lincolnxlw/Teensy-4.1-example/Teensy4.1-example.kicad_pcb

## KiCad design Teensy4.1-example.kicad_pcb (2024-11-22)

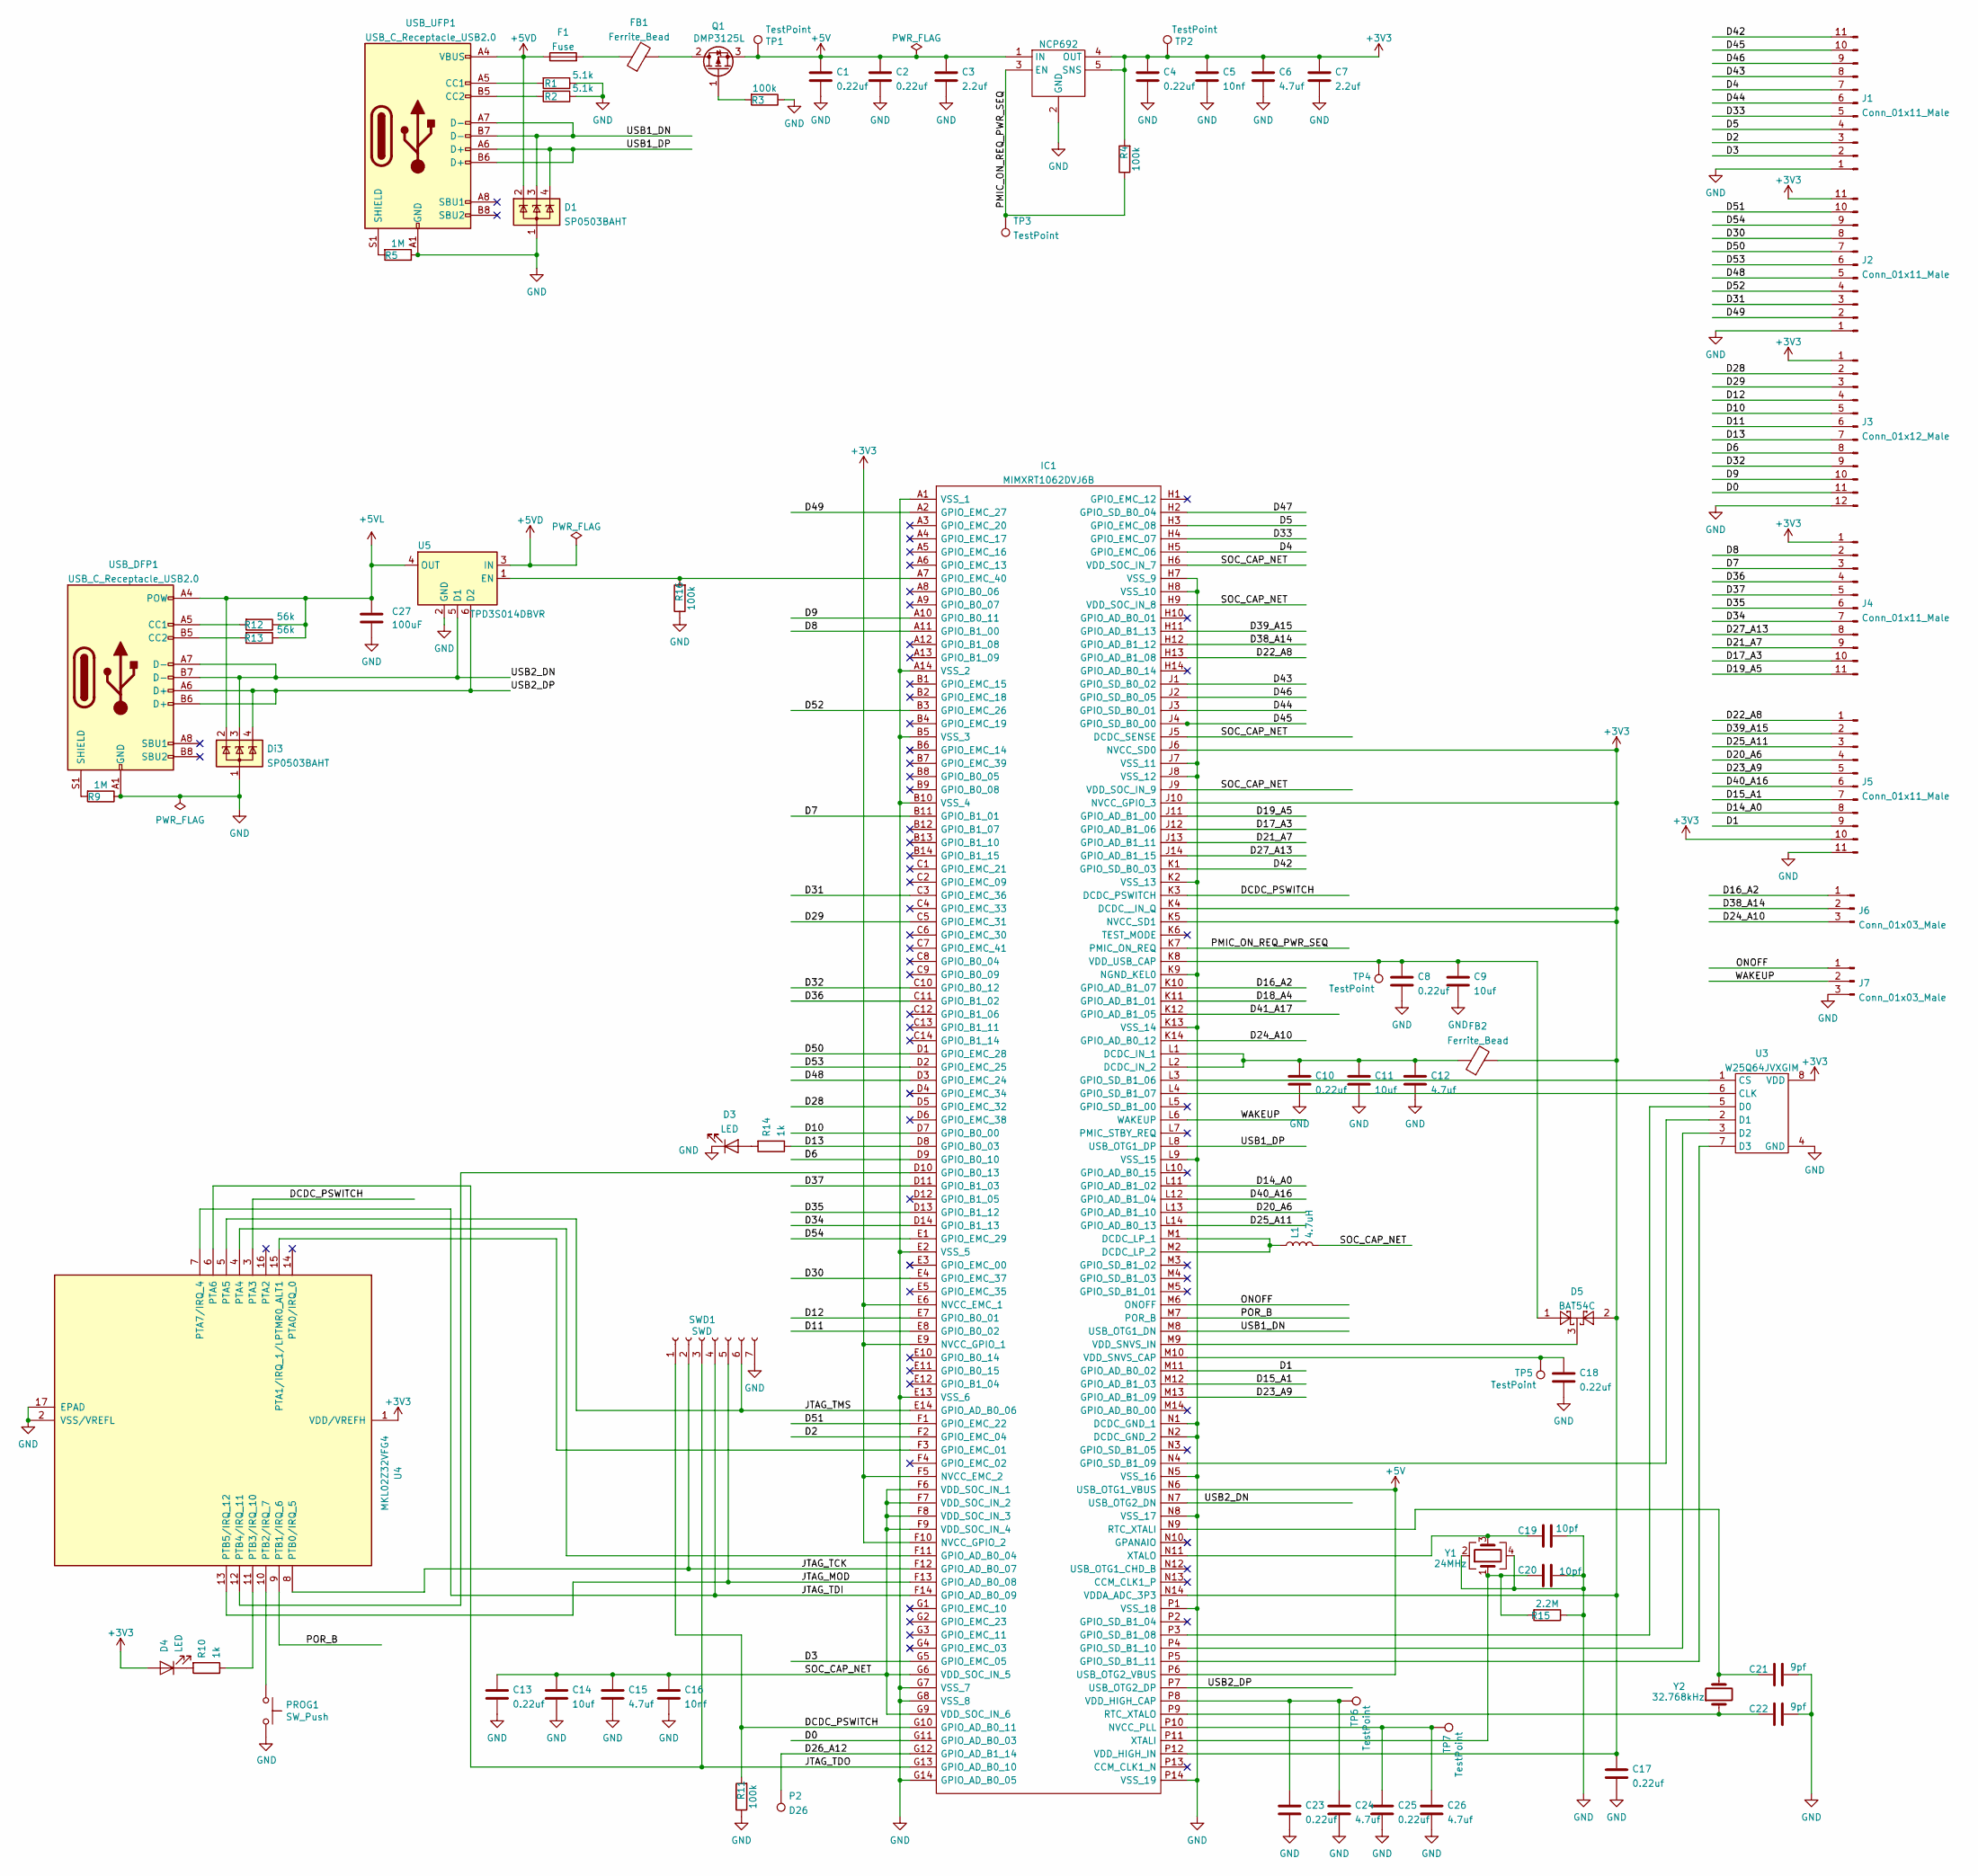
[picture p1: schematic Teensy4.1-example.kicad_sch, Teensy 4.1 example design Kicad]

Parts:
C1, C2, C4, C8, C10, C13, C17, C18, C23, C25: 0.22uf; C_0603_1608Metric; MPN CC0603KRX7R6BB224; LCSC C106216
C3, C7: 2.2uf; C_0603_1608Metric; MPN CL10B225KP8NNNC; LCSC C100082
C5, C16: 10nf; C_0603_1608Metric; MPN 0603B103K160CT; LCSC C163173
C6, C12, C15, C24, C26: 4.7uf; C_0603_1608Metric; MPN CL10B475KQ8NQNC; LCSC C107368
C9, C11, C14: 10uf; C_0805_2012Metric; MPN GRM21BR71A106KA73K; LCSC C2167686
C19, C20: 10pf; C_0603_1608Metric; MPN CC0603KRX7R6BB224; LCSC C1634
C21, C22: 9pf; C_0603_1608Metric; MPN GRM1885C1H9R0DA01D; LCSC C430713
C27: 100uF; C_1206_3216Metric; LCSC C883598
D1: SP0503BAHT; SOT-143; LCSC C3040626
D3, D4: LED; LED_0402_1005Metric; LCSC C264407
D5: BAT54C; SOT-23; LCSC C266596
Di3: SP0503BAHT; SOT-143; LCSC C3040626
F1: Fuse; R_0805_2012Metric; MPN 0ZCK0050FF2E; LCSC C5220829
FB1, FB2: Ferrite_Bead; R_0805_2012Metric; MPN FBMH2012HM121-T‎; LCSC C454098
IC1: MIMXRT1062DVJ6B; BGA196C80P14X14_1200X1200X152; Mouser Part Number 771-MIMXRT1062DVJ6B
J1, J2, J4, J5: Conn_01x11_Male; PinHeader_1x11_P2.54mm_Vertical
J3: Conn_01x12_Male; PinHeader_1x12_P2.54mm_Vertical
J6, J7: Conn_01x03_Male; PinHeader_1x03_P2.54mm_Vertical
L1: 4.7uH; C_0805_2012Metric; MPN LQM21PN4R7MGRD; LCSC C86090
NCP692: OnSemi NCP692, fixed version; DFN-6-1EP_3x3mm_P0.95mm_EP1.7x2.6mm; MPN NCP692MN33T2G; LCSC C145519
P2: D26; PinHeader_1x01_P1.00mm_Vertical
PROG1: SW_Push; KMR241GLFS; MPN KMR241GLFS; LCSC C221682
Q1: DMP3125L; SOT-23; LCSC C459542
R1, R2: 5.1k; R_0603_1608Metric; MPN RC0603FR-075K1L; LCSC C105580
R3, R4, R11, R16: 100k; R_0603_1608Metric; LCSC C15458
R5, R9: 1M; R_0603_1608Metric; LCSC C22935
R10, R14: 1k; R_0402_1005Metric; LCSC C11702
R12, R13: 56k; R_0603_1608Metric; MPN RMCF0603FT56K0; LCSC C23206
R15: 2.2M; R_0603_1608Metric; LCSC C18679
SWD1: SWD; PinHeader_1x07_P1.27mm_Vertical
TP1, TP2, TP3, TP4, TP5, TP6, TP7: TestPoint; TestPoint_Pad_D1.0mm
U3: W25Q64JVXGIM; XSON8_4x4mm; LCSC C5440778
U4: MKL02Z32VFG4; QFN-16-1EP_3x3mm_P0.5mm_EP1.8x1.8mm; MPN Custom firmware part
U5: TPD3S014DBVR; SOT-23-6; LCSC C87384
USB_DFP1: USB_C_Receptacle_USB2.0; TYPE-C-31-M-14; LCSC C223907
USB_UFP1: USB_C_Receptacle_USB2.0; TYPE-C-31-M-14; LCSC C223907
Y1: 24MHz; Crystal_SMD_Abracon_ABM3B-4Pin_5.0x3.2mm; LCSC C5544458
Y2: 32.768kHz; Crystal_SMD_2012-2Pin_2.0x1.2mm; MPN ABS06-32.768KHZ-9-1-T; LCSC C510776

Connections:
+3V3: C4.1, C5.1, C6.1, C7.1, C17.1, D4.2 (A), D5.2, FB2.2, IC1.E6 (NVCC_EMC_1), IC1.E9 (NVCC_GPIO_1), IC1.F5 (NVCC_EMC_2), IC1.F10 (NVCC_GPIO_2), IC1.J6 (NVCC_SD0), IC1.J10 (NVCC_GPIO_3), IC1.K4 (DCDC__IN_Q), IC1.K5 (NVCC_SD1), IC1.N14 (VDDA_ADC_3P3), IC1.P12 (VDD_HIGH_IN), J2.11, J3.1, J4.1, J5.10, NCP692.4 (OUT), NCP692.5 (SNS), R4.2, TP2.1, U3.8 (VDD), U4.1 (VDD/VREFH)
+5V: C1.1, C2.1, C3.1, IC1.N6 (USB_OTG1_VBUS), IC1.P6 (USB_OTG2_VBUS), NCP692.1 (IN), NCP692.6 (IN), Q1.3 (S), TP1.1
+5VD: D1.2 (K), F1.1, U5.3 (IN), USB_UFP1.A4 (VBUS), USB_UFP1.A9 (VBUS), USB_UFP1.B4 (VBUS), USB_UFP1.B9 (VBUS)
+5VL: C27.1, Di3.2 (K), R12.1, R13.1, U5.4 (OUT), USB_DFP1.A4 (POW), USB_DFP1.A9 (POW), USB_DFP1.B4 (POW), USB_DFP1.B9 (POW)
/D0: IC1.G11 (GPIO_AD_B0_03), J3.11
/D1: IC1.M11 (GPIO_AD_B0_02), J5.9
/D2: IC1.F2 (GPIO_EMC_04), J1.3
/D3: IC1.G5 (GPIO_EMC_05), J1.2
/D4: IC1.H5 (GPIO_EMC_06), J1.7
/D5: IC1.H3 (GPIO_EMC_08), J1.4
/D6: IC1.D9 (GPIO_B0_10), J3.8
/D7: IC1.B11 (GPIO_B1_01), J4.3
/D8: IC1.A11 (GPIO_B1_00), J4.2
/D9: IC1.A10 (GPIO_B0_11), J3.10
/D10: IC1.D7 (GPIO_B0_00), J3.5
/D11: IC1.E8 (GPIO_B0_02), J3.6
/D12: IC1.E7 (GPIO_B0_01), J3.4
/D13: IC1.D8 (GPIO_B0_03), J3.7, R14.1
/D14_A0: IC1.L11 (GPIO_AD_B1_02), J5.8
/D15_A1: IC1.M12 (GPIO_AD_B1_03), J5.7
/D16_A2: IC1.K10 (GPIO_AD_B1_07), J6.1
/D17_A3: IC1.J12 (GPIO_AD_B1_06), J4.10
/D18_A4: IC1.K11 (GPIO_AD_B1_01)
/D19_A5: IC1.J11 (GPIO_AD_B1_00), J4.11
/D20_A6: IC1.L13 (GPIO_AD_B1_10), J5.4
/D21_A7: IC1.J13 (GPIO_AD_B1_11), J4.9
/D22_A8: IC1.H13 (GPIO_AD_B1_08), J5.1
/D23_A9: IC1.M13 (GPIO_AD_B1_09), J5.5
/D24_A10: IC1.K14 (GPIO_AD_B0_12), J6.3
/D25_A11: IC1.L14 (GPIO_AD_B0_13), J5.3
/D26_A12: IC1.G12 (GPIO_AD_B1_14), P2.1
/D27_A13: IC1.J14 (GPIO_AD_B1_15), J4.8
/D28: IC1.D5 (GPIO_EMC_32), J3.2
/D29: IC1.C5 (GPIO_EMC_31), J3.3
/D30: IC1.E4 (GPIO_EMC_37), J2.8
/D31: IC1.C3 (GPIO_EMC_36), J2.3
/D32: IC1.C10 (GPIO_B0_12), J3.9
/D33: IC1.H4 (GPIO_EMC_07), J1.5
/D34: IC1.D14 (GPIO_B1_13), J4.7
/D35: IC1.D13 (GPIO_B1_12), J4.6
/D36: IC1.C11 (GPIO_B1_02), J4.4
/D37: IC1.D11 (GPIO_B1_03), J4.5
/D38_A14: IC1.H12 (GPIO_AD_B1_12), J6.2
/D39_A15: IC1.H11 (GPIO_AD_B1_13), J5.2
/D40_A16: IC1.L12 (GPIO_AD_B1_04), J5.6
/D41_A17: IC1.K12 (GPIO_AD_B1_05)
/D42: IC1.K1 (GPIO_SD_B0_03), J1.11
/D43: IC1.J1 (GPIO_SD_B0_02), J1.8
/D44: IC1.J3 (GPIO_SD_B0_01), J1.6
/D45: IC1.J4 (GPIO_SD_B0_00), J1.10
/D46: IC1.J2 (GPIO_SD_B0_05), J1.9
/D47: IC1.H2 (GPIO_SD_B0_04)
/D48: IC1.D3 (GPIO_EMC_24), J2.5
/D49: IC1.A2 (GPIO_EMC_27), J2.2
/D50: IC1.D1 (GPIO_EMC_28), J2.7
/D51: IC1.F1 (GPIO_EMC_22), J2.10
/D52: IC1.B3 (GPIO_EMC_26), J2.4
/D53: IC1.D2 (GPIO_EMC_25), J2.6
/D54: IC1.E1 (GPIO_EMC_29), J2.9
/DCDC_PSWITCH: IC1.G10 (GPIO_AD_B0_11), IC1.K3 (DCDC_PSWITCH), R11.2, SWD1.1, U4.3 (PTA3)
/JTAG_MOD: IC1.F13 (GPIO_AD_B0_08), SWD1.5, U4.13 (PTB5/IRQ_12)
/JTAG_TCK: IC1.F12 (GPIO_AD_B0_07), SWD1.2, U4.8 (PTB0/IRQ_5)
/JTAG_TDI: IC1.F14 (GPIO_AD_B0_09), SWD1.4, U4.7 (PTA7/IRQ_4)
/JTAG_TDO: IC1.G13 (GPIO_AD_B0_10), SWD1.3, U4.6 (PTA6)
/JTAG_TMS: IC1.E14 (GPIO_AD_B0_06), SWD1.6, U4.5 (PTA5)
/ONOFF: IC1.M6 (ONOFF), J7.1
/PMIC_ON_REQ_PWR_SEQ: IC1.K7 (PMIC_ON_REQ), NCP692.3 (EN), R4.1, TP3.1
/POR_B: IC1.M7 (POR_B), U4.9 (PTB1/IRQ_6)
/SOC_CAP_NET: C13.1, C14.1, C15.1, C16.1, IC1.F6 (VDD_SOC_IN_1), IC1.F7 (VDD_SOC_IN_2), IC1.F8 (VDD_SOC_IN_3), IC1.F9 (VDD_SOC_IN_4), IC1.G6 (VDD_SOC_IN_5), IC1.G9 (VDD_SOC_IN_6), IC1.H6 (VDD_SOC_IN_7), IC1.H9 (VDD_SOC_IN_8), IC1.J5 (DCDC_SENSE), IC1.J9 (VDD_SOC_IN_9), L1.2
/USB1_DN: D1.3 (K), IC1.M8 (USB_OTG1_DN), USB_UFP1.A7 (D-), USB_UFP1.B7 (D-)
/USB1_DP: D1.4 (K), IC1.L8 (USB_OTG1_DP), USB_UFP1.A6 (D+), USB_UFP1.B6 (D+)
/USB2_DN: Di3.3 (K), IC1.N7 (USB_OTG2_DN), U5.5 (D1), USB_DFP1.A7 (D-), USB_DFP1.B7 (D-)
/USB2_DP: Di3.4 (K), IC1.P7 (USB_OTG2_DP), U5.6 (D2), USB_DFP1.A6 (D+), USB_DFP1.B6 (D+)
/WAKEUP: IC1.L6 (WAKEUP), J7.2
GND: C1.2, C2.2, C3.2, C4.2, C5.2, C6.2, C7.2, C8.2, C9.2, C10.2, C11.2, C12.2, C13.2, C14.2, C15.2, C16.2, C17.2, C18.2, C19.2, C20.2, C21.2, C22.2, C23.2, C24.2, C25.2, C26.2, C27.2, D1.1 (A), D3.1 (K), Di3.1 (A), IC1.A1 (VSS_1), IC1.A14 (VSS_2), IC1.B5 (VSS_3), IC1.B10 (VSS_4), IC1.E2 (VSS_5), IC1.E13 (VSS_6), IC1.G7 (VSS_7), IC1.G8 (VSS_8), IC1.G14 (GPIO_AD_B0_05), IC1.H7 (VSS_9), IC1.H8 (VSS_10), IC1.J7 (VSS_11), IC1.J8 (VSS_12), IC1.K2 (VSS_13), IC1.K9 (NGND_KEL0), IC1.K13 (VSS_14), IC1.L9 (VSS_15), IC1.N1 (DCDC_GND_1), IC1.N2 (DCDC_GND_2), IC1.N5 (VSS_16), IC1.N8 (VSS_17), IC1.P1 (VSS_18), IC1.P14 (VSS_19), J1.1, J2.1, J3.12, J5.11, J7.3, NCP692.2 (GND), NCP692.7 (GND), PROG1.2, R1.1, R2.1, R3.1, R5.1, R9.1, R11.1, R15.1, R16.1, SWD1.7, U3.4 (GND), U4.2 (VSS/VREFL), U4.17 (EPAD), U5.2 (GND), USB_DFP1.A1 (GND), USB_DFP1.A12 (GND), USB_DFP1.B1 (GND), USB_DFP1.B12 (GND), USB_UFP1.A1 (GND), USB_UFP1.A12 (GND), USB_UFP1.B1 (GND), USB_UFP1.B12 (GND), Y1.2, Y1.4
unnamed: D3.2 (A), R14.2
unnamed: D4.1 (K), R10.2
unnamed: F1.2, FB1.1
unnamed: C10.1, C11.1, C12.1, FB2.1, IC1.L1 (DCDC_IN_1), IC1.L2 (DCDC_IN_2)
unnamed: IC1.M1 (DCDC_LP_1), IC1.M2 (DCDC_LP_2), L1.1
unnamed: IC1.F11 (GPIO_AD_B0_04), U4.4 (PTA4)
unnamed: IC1.D10 (GPIO_B0_13), U4.12 (PTB4/IRQ_11)
unnamed: IC1.F3 (GPIO_EMC_01), U4.15 (PTA1/IRQ_1/LPTMR0_ALT1)
unnamed: IC1.A7 (GPIO_EMC_40), R16.2, U5.1 (EN)
unnamed: IC1.L3 (GPIO_SD_B1_06), U3.1 (CS)
unnamed: IC1.L4 (GPIO_SD_B1_07), U3.6 (CLK)
unnamed: IC1.P3 (GPIO_SD_B1_08), U3.5 (D0)
unnamed: IC1.N4 (GPIO_SD_B1_09), U3.2 (D1)
unnamed: IC1.P4 (GPIO_SD_B1_10), U3.3 (D2)
unnamed: IC1.P5 (GPIO_SD_B1_11), U3.7 (D3)
unnamed: C25.1, C26.1, IC1.P10 (NVCC_PLL), TP7.1
unnamed: C21.1, IC1.N9 (RTC_XTALI), Y2.2
unnamed: C22.1, IC1.P9 (RTC_XTALO), Y2.1
unnamed: C23.1, C24.1, IC1.P8 (VDD_HIGH_CAP), TP6.1
unnamed: C18.1, IC1.M10 (VDD_SNVS_CAP), TP5.1
unnamed: D5.3, IC1.M9 (VDD_SNVS_IN)
unnamed: C8.1, C9.1, D5.1, IC1.K8 (VDD_USB_CAP), TP4.1
unnamed: C20.1, IC1.P11 (XTALI), R15.2, Y1.1
unnamed: C19.1, IC1.N11 (XTALO), Y1.3
unnamed: FB1.2, Q1.2 (D)
unnamed: Q1.1 (G), R3.2
unnamed: PROG1.1, U4.10 (PTB2/IRQ_7)
unnamed: R10.1, U4.11 (PTB3/IRQ_10)
unnamed: R12.2, USB_DFP1.A5 (CC1)
unnamed: R13.2, USB_DFP1.B5 (CC2)
unnamed: R9.2, USB_DFP1.S1 (SHIELD)
unnamed: R1.2, USB_UFP1.A5 (CC1)
unnamed: R2.2, USB_UFP1.B5 (CC2)
unnamed: R5.2, USB_UFP1.S1 (SHIELD)

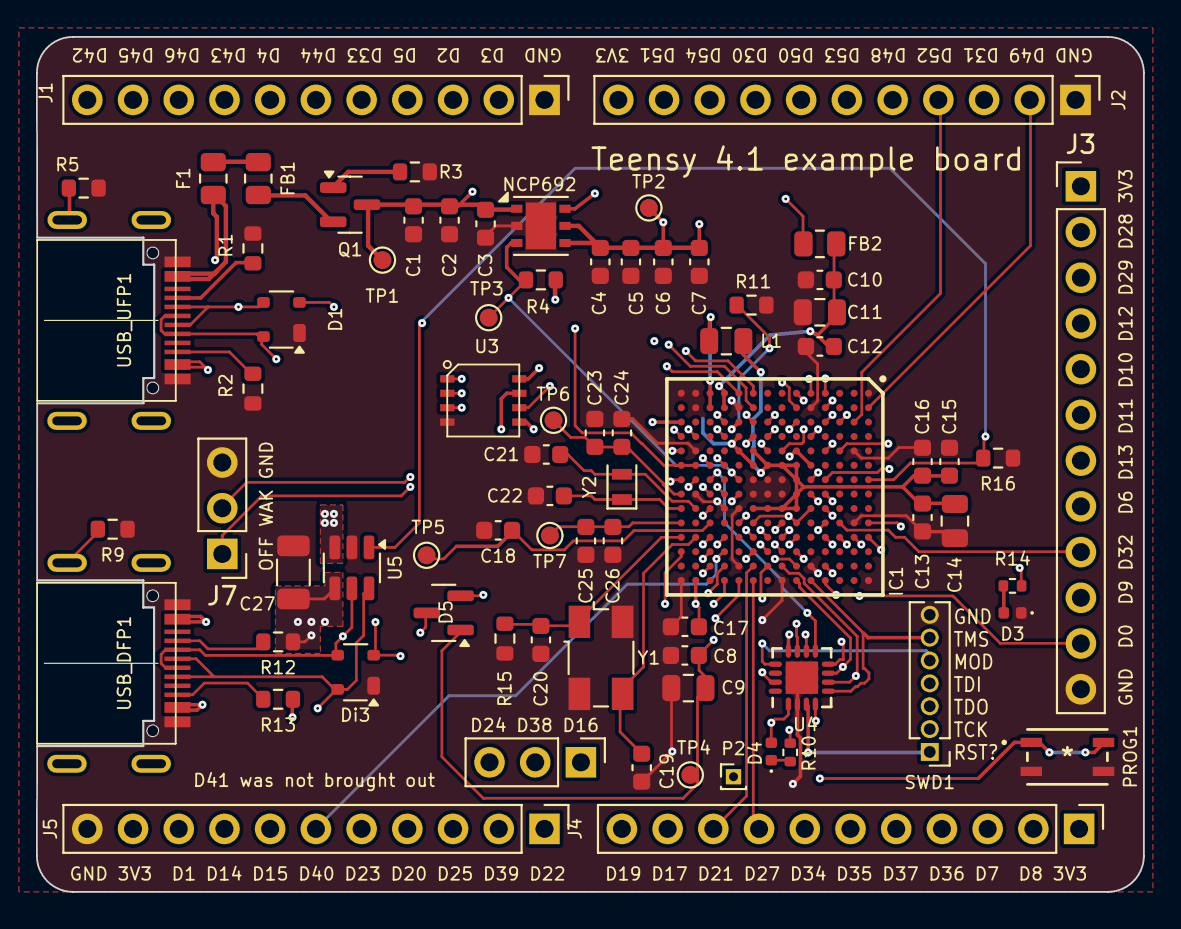
[picture p2: board Teensy4.1-example.kicad_pcb from above]

Board: 4 copper layers, 61.5 x 47.5 mm, 76 parts (0 on the bottom side), 106 nets.
