lincolnxlw/Teensy-4.1-example/(commit log)

2024-11-21 Migrate to kicad8
    [Teensy4.1-example.kicad_pcb, Teensy4.1-example.kicad_sch]
2024-11-21 Schematics changes - Back to use TPD3S014DBVR for USB switch - Add JLC part numbers
    [Teensy4.1-example.kicad_sch]
2024-11-22 Update layout
    [Teensy4.1-example.kicad_pcb]
2024-11-22 Remove the RGB LED
    [Teensy4.1-example.kicad_pcb, Teensy4.1-example.kicad_sch]
2024-11-22 Generate production files
    [bom.csv, designators.csv, positions.csv]
